p0lysim/Polysim_Grip/README.md

<div align="center">

# Polysim Grip G1

**An open, 3D-printable flight simulator joystick grip with a thumb stick, a side button and an I2C interface.**











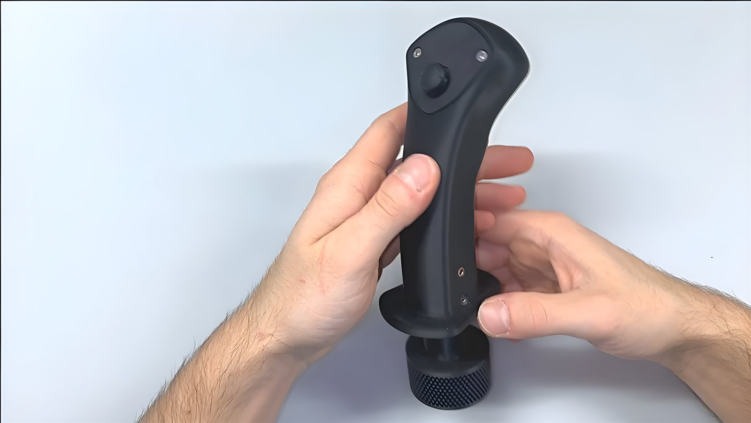
[picture p1: docs/images/grip-g1-cover.jpg]
Polysim Grip G1 – 3D-printed grip held in hand


<a href="https://polysim.fr/products/polysim-grip-3d-printable-kit">Buy the Polysim Grip kit on polysim.fr</a>

</div>

---

## 🎯 Overview

A 3D-printable joystick grip with a thumb stick and a side button. It talks to the joystick base over I2C.

<table>
<tr>
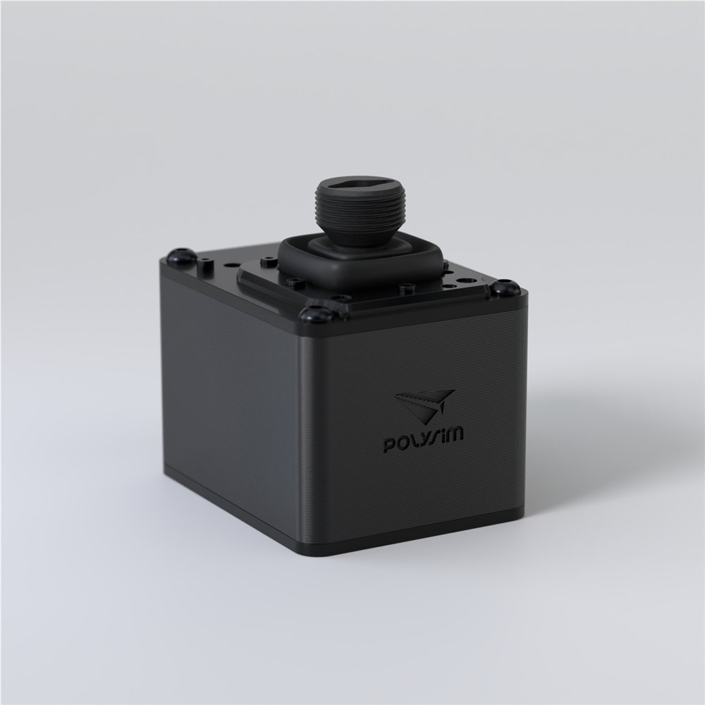
[picture p2: docs/images/polysim-base.jpg]
Polysim Base joystick
<td width="140" valign="middle"></td>
<td valign="middle">🔗 <b>Made for the <a href="https://github.com/p0lysim/Polysim_Base">Polysim Base</a>.</b><br>
The grip locks onto the base with its knurled ring and plugs in through the 4-pole jack.
The base reads it and sends everything to the PC over USB.</td>
</tr>
</table>

## 📥 Download

| Files | Folder | Printables | Thingiverse | MakerWorld |
|---|---|---|---|---|
| **STL** – one per part | [`cad/stl`](cad/stl) | [Download](https://www.printables.com/model/1278269-3d-printable-flight-simulator-joystick-grip) | [Download](https://www.thingiverse.com/thing:6879827) | [Download](https://makerworld.com/en/models/3599817-polysim-grip-3d-printable-flight-sim-joystick-grip) |
| **3MF** – print plates | [`cad/3mf`](cad/3mf) | — | — | [Print profile](https://makerworld.com/en/models/3599817-polysim-grip-3d-printable-flight-sim-joystick-grip#profileId-4124642) |
| **STEP** – full assembly with PCB | [`cad/step`](cad/step) | — | — | — |

## 🛒 Get the kit

The **[Polysim Grip kit](https://polysim.fr/products/polysim-grip-3d-printable-kit)** contains **every component
needed for the assembly**. You only have to **print the plastic parts in PLA or PETG**, then follow the assembly video.

<p align="center">
  <a href="https://polysim.fr/products/polysim-grip-3d-printable-kit">Buy the Polysim Grip kit on polysim.fr</a>
</p>

| Exploded view | Assembly tutorial |
|:---:|:---:|
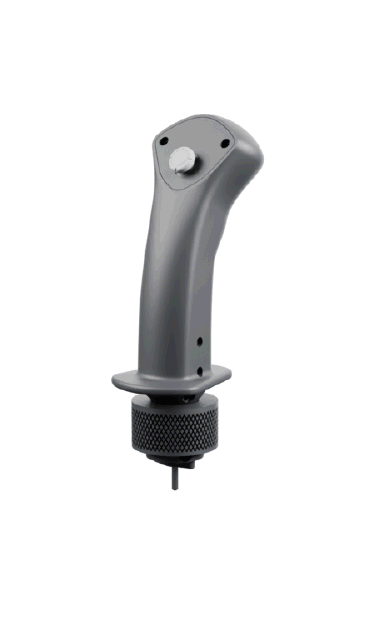
[picture p3: docs/images/grip-exploded.gif]
Rotating exploded view of the Polysim Grip G1
|  | <a href="https://www.youtube.com/watch?v=2aSrMxbHL8U">Polysim grip G1 assembly tutorial</a> |

## 🔌 How it connects

<p align="center">
  Connection diagram from PCB renders: thumb stick on CN1, side button on U7, grip U5 to GRIP_IN on the Y encoder PCB, GRIP OUT to GRIP on the base PCB, X and Y encoders on ENC_X and ENC_Y, base to the PC over USB-C
</p>

The BASE side (encoder PCBs and base PCB) belongs to the [Polysim Base](https://github.com/p0lysim/Polysim_Base) project.
More details are in [docs/hardware.md](docs/hardware.md).

## 💾 Firmware

The grip PCB has no USB port: flash it through its **ICSP header (J1)** with a USBasp or an *Arduino as ISP*.

1. In the Arduino IDE, open `firmware/polysim_grip/polysim_grip.ino`.
2. Select **Tools → Board → Arduino Nano**, then **Tools → Programmer → USBasp** (or *Arduino as ISP*).
3. Connect the programmer to J1, then click **Sketch → Upload Using Programmer**.

On a brand-new chip, run **Tools → Burn Bootloader** once first: it sets the fuses for the 16 MHz crystal.

## 📡 I2C protocol

See [docs/i2c-protocol.md](docs/i2c-protocol.md).

## 📄 License

Released under the [Sustainable Use License 1.0](LICENSE.md):

- ✅ Personal, non-commercial and internal use, modification and free redistribution.
- ❌ Commercial use (for example selling printed grips or kits) is not permitted.

Redistributed copies must include the license, and modified copies must say they were modified.
