p0lysim/Polysim_Grip/cad/step/grip-g1.step

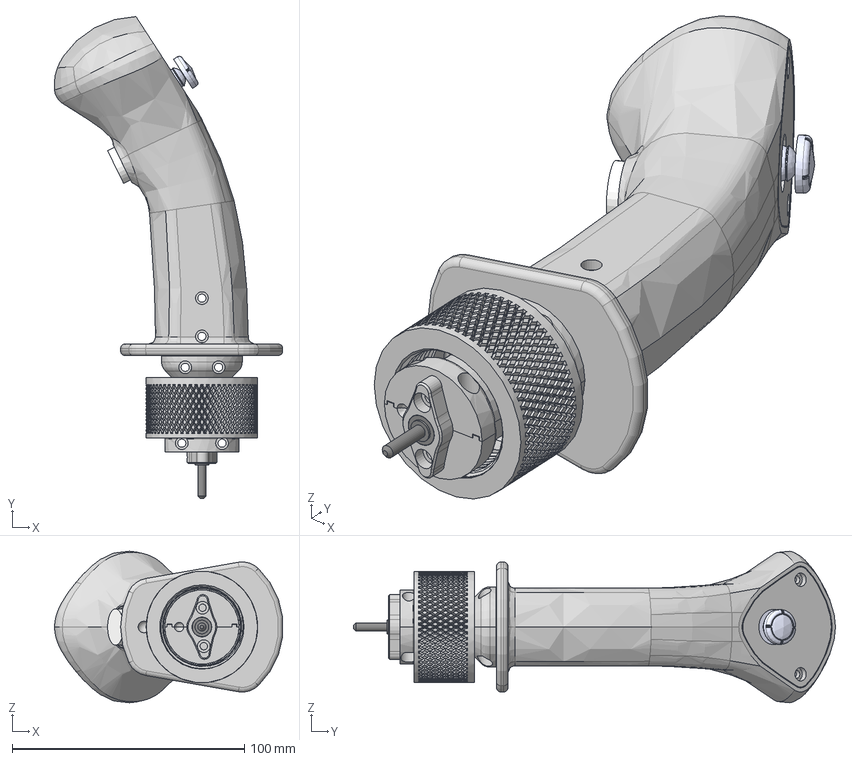
[picture p4: CAD file, 2026-08-10]
cad/step/grip-g1.step
98.5 x 207.7 x 65.3 mm
Button
Joystick V2
