p0lysim/Polysim_Grip/cad/stl/jonction_v2.stl

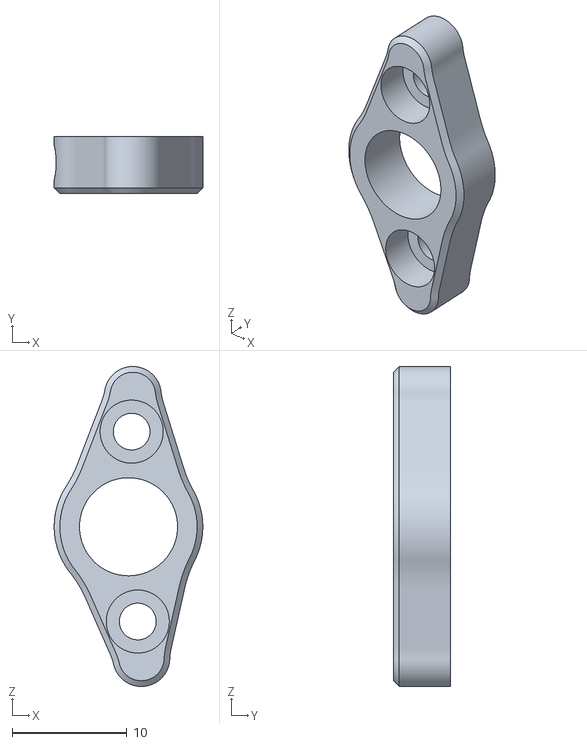
[picture p5: CAD file, 2026-11-12]
cad/stl/jonction_v2.stl
13.0 x 5.00 x 27.9
