p0lysim/Polysim_Grip/cad/stl/plate.stl

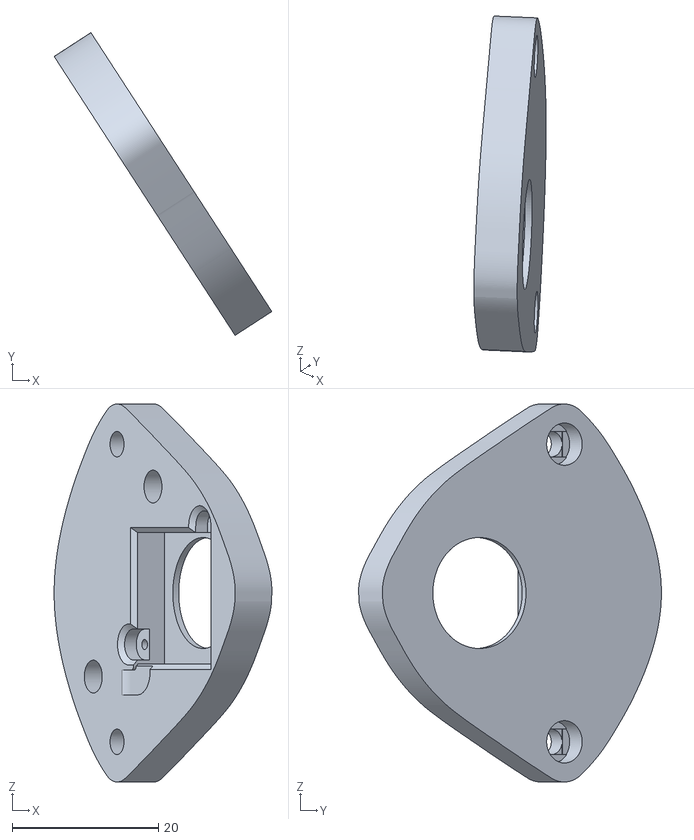
[picture p6: CAD file, 2026-11-12]
cad/stl/plate.stl
29.8 x 41.5 x 51.8
