p0lysim/Polysim_Grip/cad/stl/export_linder_v2_1p.stl

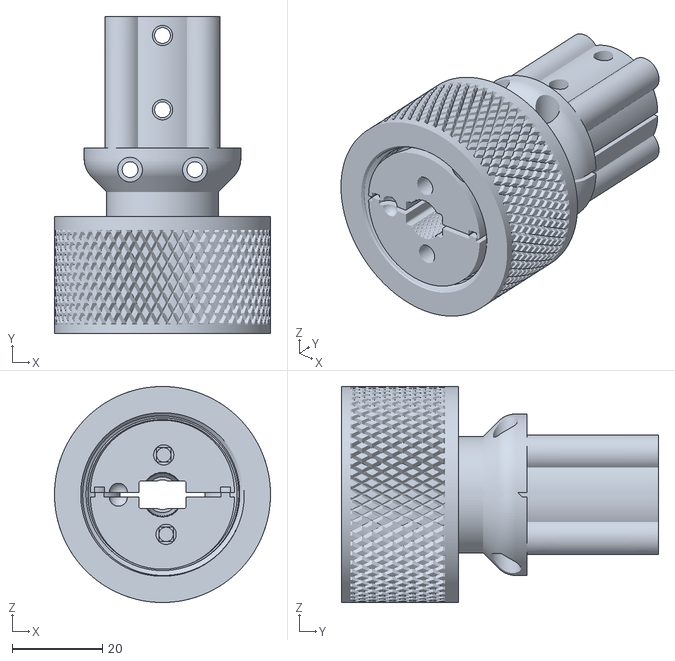
[picture p7: CAD file, 2026-11-12]
cad/stl/export_linder_v2_1p.stl
48.0 x 70.5 x 48.0
