p0lysim/Polysim_Grip/cad/stl/spacer-one-piece.stl

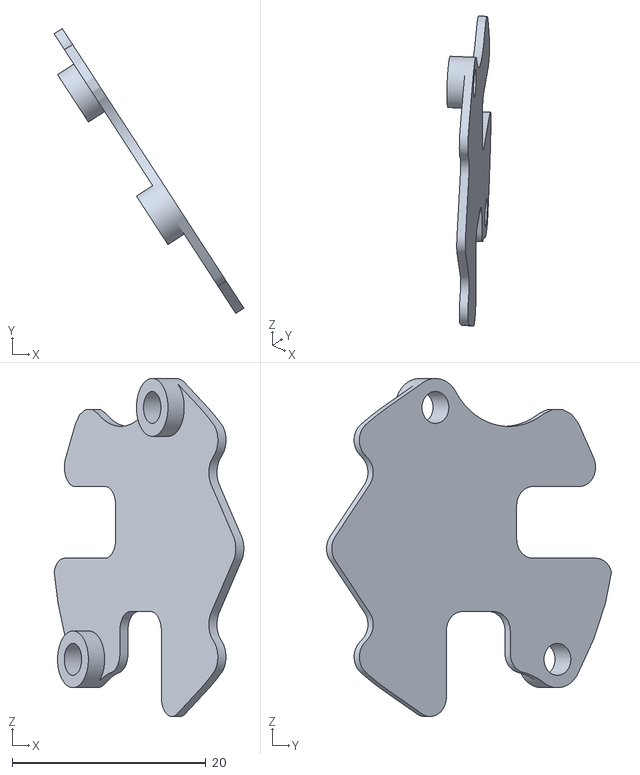
[picture p8: CAD file, 2026-11-12]
cad/stl/spacer-one-piece.stl
19.6 x 29.4 x 34.9
