p0lysim/Polysim_Grip/cad/stl/grip_singlepiece.stl

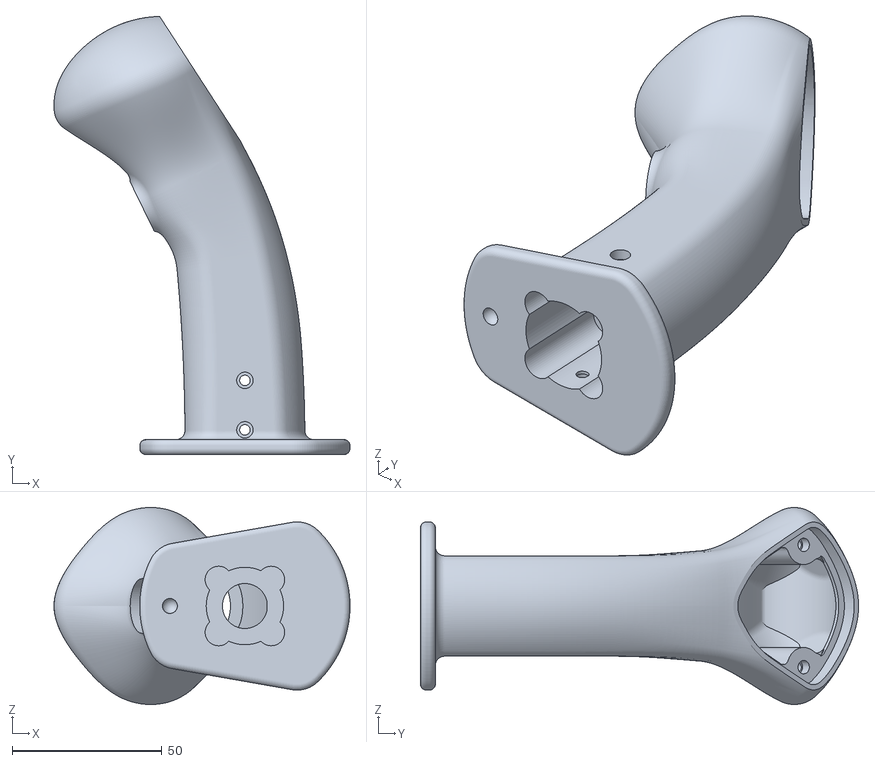
[picture p9: CAD file, 2026-11-12]
cad/stl/grip_singlepiece.stl
98.7 x 146.1 x 65.7
