p0lysim/Polysim_Grip/(list of files, cad)

Other CAD files:
cad/3mf/grip G1.3mf
