p0lysim/Polysim_Grip/(commit log)

2026-11-12 Reorganize repository and rewrite README
    - Move CAD to cad/grip-g1.step and render to docs/images/grip-g1.png
    - Add grip firmware under firmware/polysim_grip/
    - Add hardware and I2C protocol documentation in docs/
    - Rewrite README with Printables and Thingiverse links (MakerWorld coming soon)
    - Rename Licence.md to LICENSE.md and remove preamble copied from another project
    - Add CHANGELOG, .gitignore and .gitattributes
    [grip-g1.step]
2026-11-12 Add STL parts, connection diagram and ISP flashing guide
    - Split cad/ into step/ (full assembly with PCB), stl/ (one file per printable part) and 3mf/ (empty for now)
    - Add 19 STL files exported from the Fusion design (revision v91)
    - Add connection diagram (docs/images/wiring.svg) based on the grip PCB
    - Simplify docs/hardware.md around the diagram and the kit link
    - README: shorter overview, link to the Polysim kit, Arduino IDE upload via the ICSP header
    - Remove the repository structure, customizing and contributing sections
    [fillet.stl, fixation_connecteur_1.stl, fixation_connecteur_2.stl, grip-g1.step, grip_1_1_1.stl, grip_1_2_2.stl, grip_l.stl, grip_r.stl]
2026-11-12 Redraw connection diagram from grip and base PCBs, condense README
    - Connection diagram: grip PCB -> 4-wire cable -> GRIP_IN (Y encoder PCB) -> GRIP (base PCB) -> USB
    - README: one download table with repo folders, "Get the kit" section with the assembly video
    - README: shorter overview and firmware steps, I2C section now links to the protocol doc
    - Update docs/hardware.md and CHANGELOG
2026-11-12 Update STL parts and add 3MF print file
    - Replace STL files with the correct printable parts
    - Add cad/3mf/grip G1.3mf
    - README: 3MF now available in cad/3mf
    [export_linder_v2_1p.stl, fillet.stl, fixation_connecteur_1.stl, fixation_connecteur_2.stl, grip G1.3mf, grip_1_1_1.stl, grip_1_2_2.stl, grip_l.stl]
2026-11-12 Use grip photo as README cover image
    - Add docs/images/grip-g1-cover.jpg (1600 px)
    - Remove the old CAD render docs/images/grip-g1.png
2026-11-12 Add exploded-view GIF, PCB-based wiring diagram and kit button
    - Add a rotating exploded-view GIF rendered from the Fusion assembly
    - Rebuild the connection diagram from renders of the grip, Y encoder, X encoder and base PCBs,
    with wires on the right connectors and pin names from the EasyEDA design files
    - README: prominent "Buy the Grip kit" button and YouTube thumbnail for the assembly tutorial
    - Firmware: the grip PCB has a 16 MHz crystal, Burn Bootloader is fine on a new chip
    - docs: connection table in hardware.md, PCA9548A channel note in i2c-protocol.md
2026-11-12 Blender exploded-view GIF, separate GRIP/BASE boxes, smaller kit button
    - Re-render the exploded view in Blender (Cycles) with realistic materials
    - Step-by-step disassembly: no part passes through another, and the knurled nut
    stays captive on the two linker halves
    - Wiring diagram: two separate GRIP and BASE boxes, GRIP highlighted
    - Smaller blue "Buy the kit" button
    - Kit text: every component is included, only the plastic parts need printing (PLA or PETG)
2026-11-12 Highlight compatibility with the Polysim Base
    - Add a "Compatible with Polysim Base" badge at the top of the README
    - Add a "Made for the Polysim Base" note in the overview
    - Link the BASE side of the wiring diagram and docs/hardware.md to the Polysim Base repository
2026-11-12 Add MakerWorld links
    - MakerWorld badge now links to the published model
    - Download table: MakerWorld STL download and print profile (3MF)
