p0lysim/Polysim_Grip/(notices)

Notices in the files:
README.md:
License: Sustainable Use
